uob-hep-cad/uob-hep-pc074/README.md

# Simple Charge Sensitive Amplifier with Integrated Shaping Amplifier

1000 electrons --> 8mV at output of shaper . i.e. ~ 50V/pC
