uob-hep-cad/uob-hep-pc074/www/Schematics/UoB TICSP.pdf

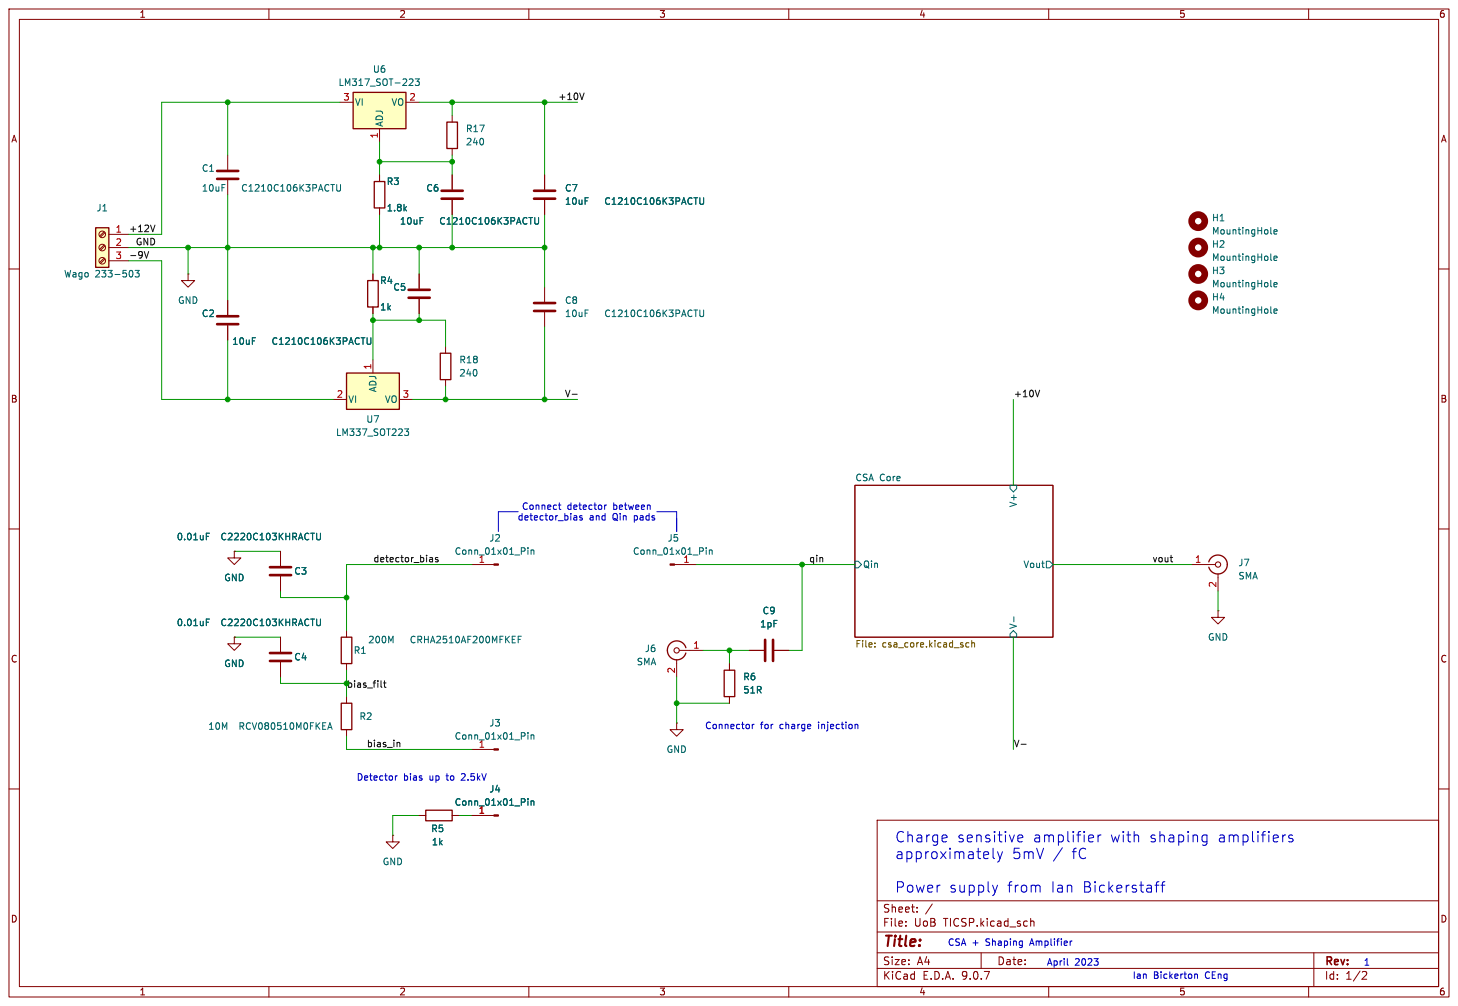
[picture p1: page 1]

Power supply from Ian Bickerstaff

April 2023 CSA + Shaping Amplifier

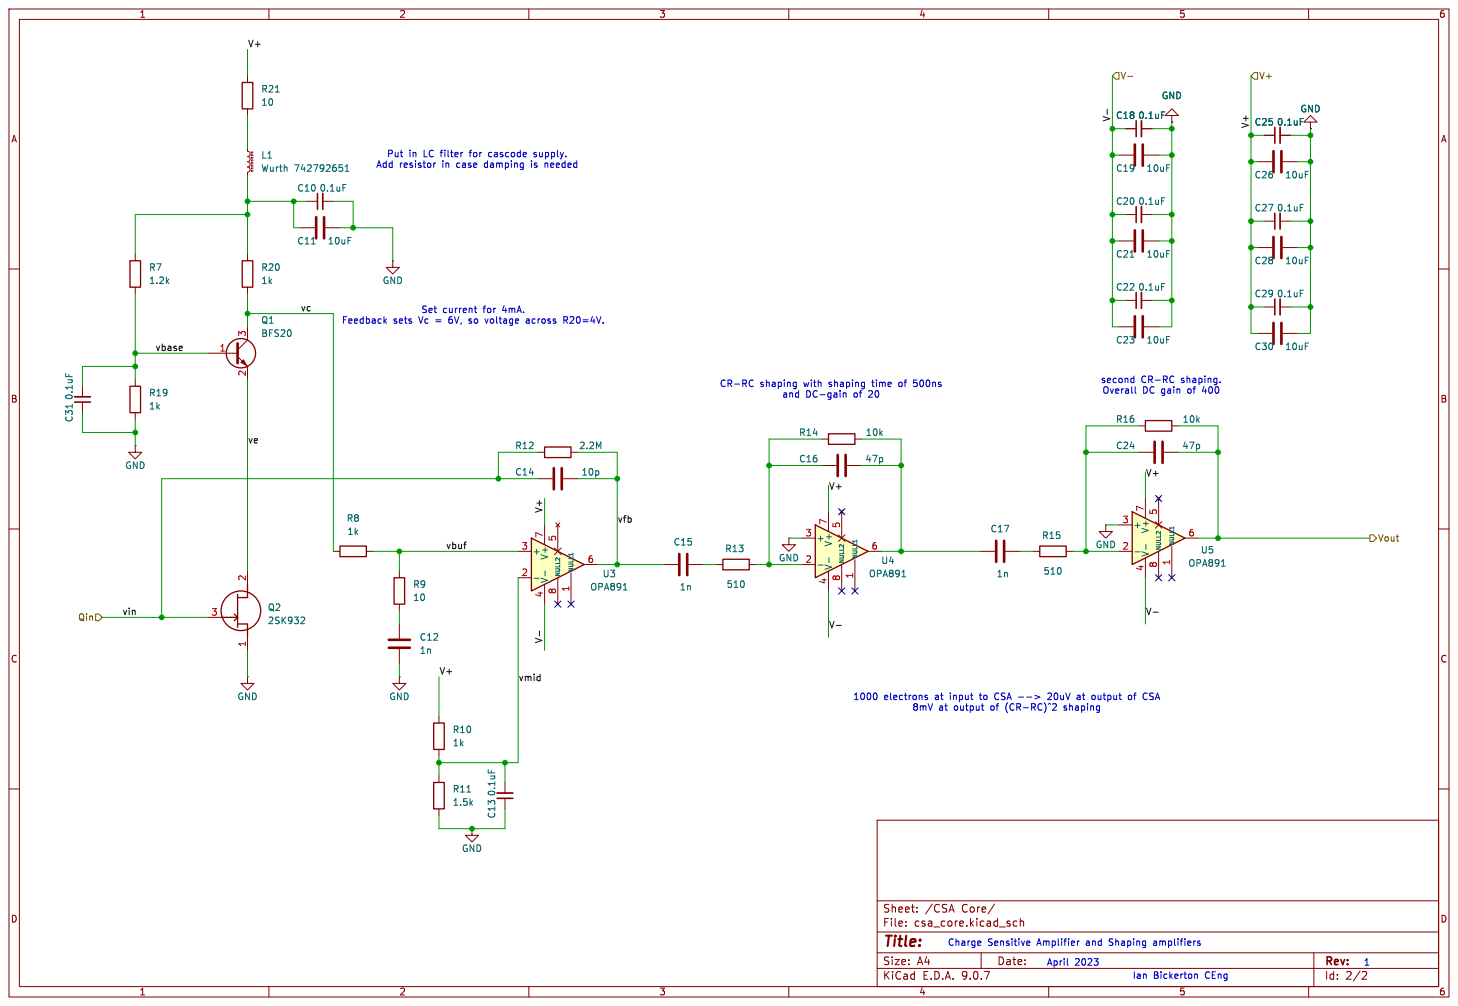
[picture p2: page 2]

Id: 2/2 Title: File: csa_core.kicad_sch Sheet: /CSA Core/
