uob-hep-cad/uob-hep-pc074/hardware/KiCad/uob-hep-pc074/uob-hep-pc074.kicad_pcb

## KiCad design hardware/KiCad/uob-hep-pc074/uob-hep-pc074.kicad_pcb (2026-04-07)

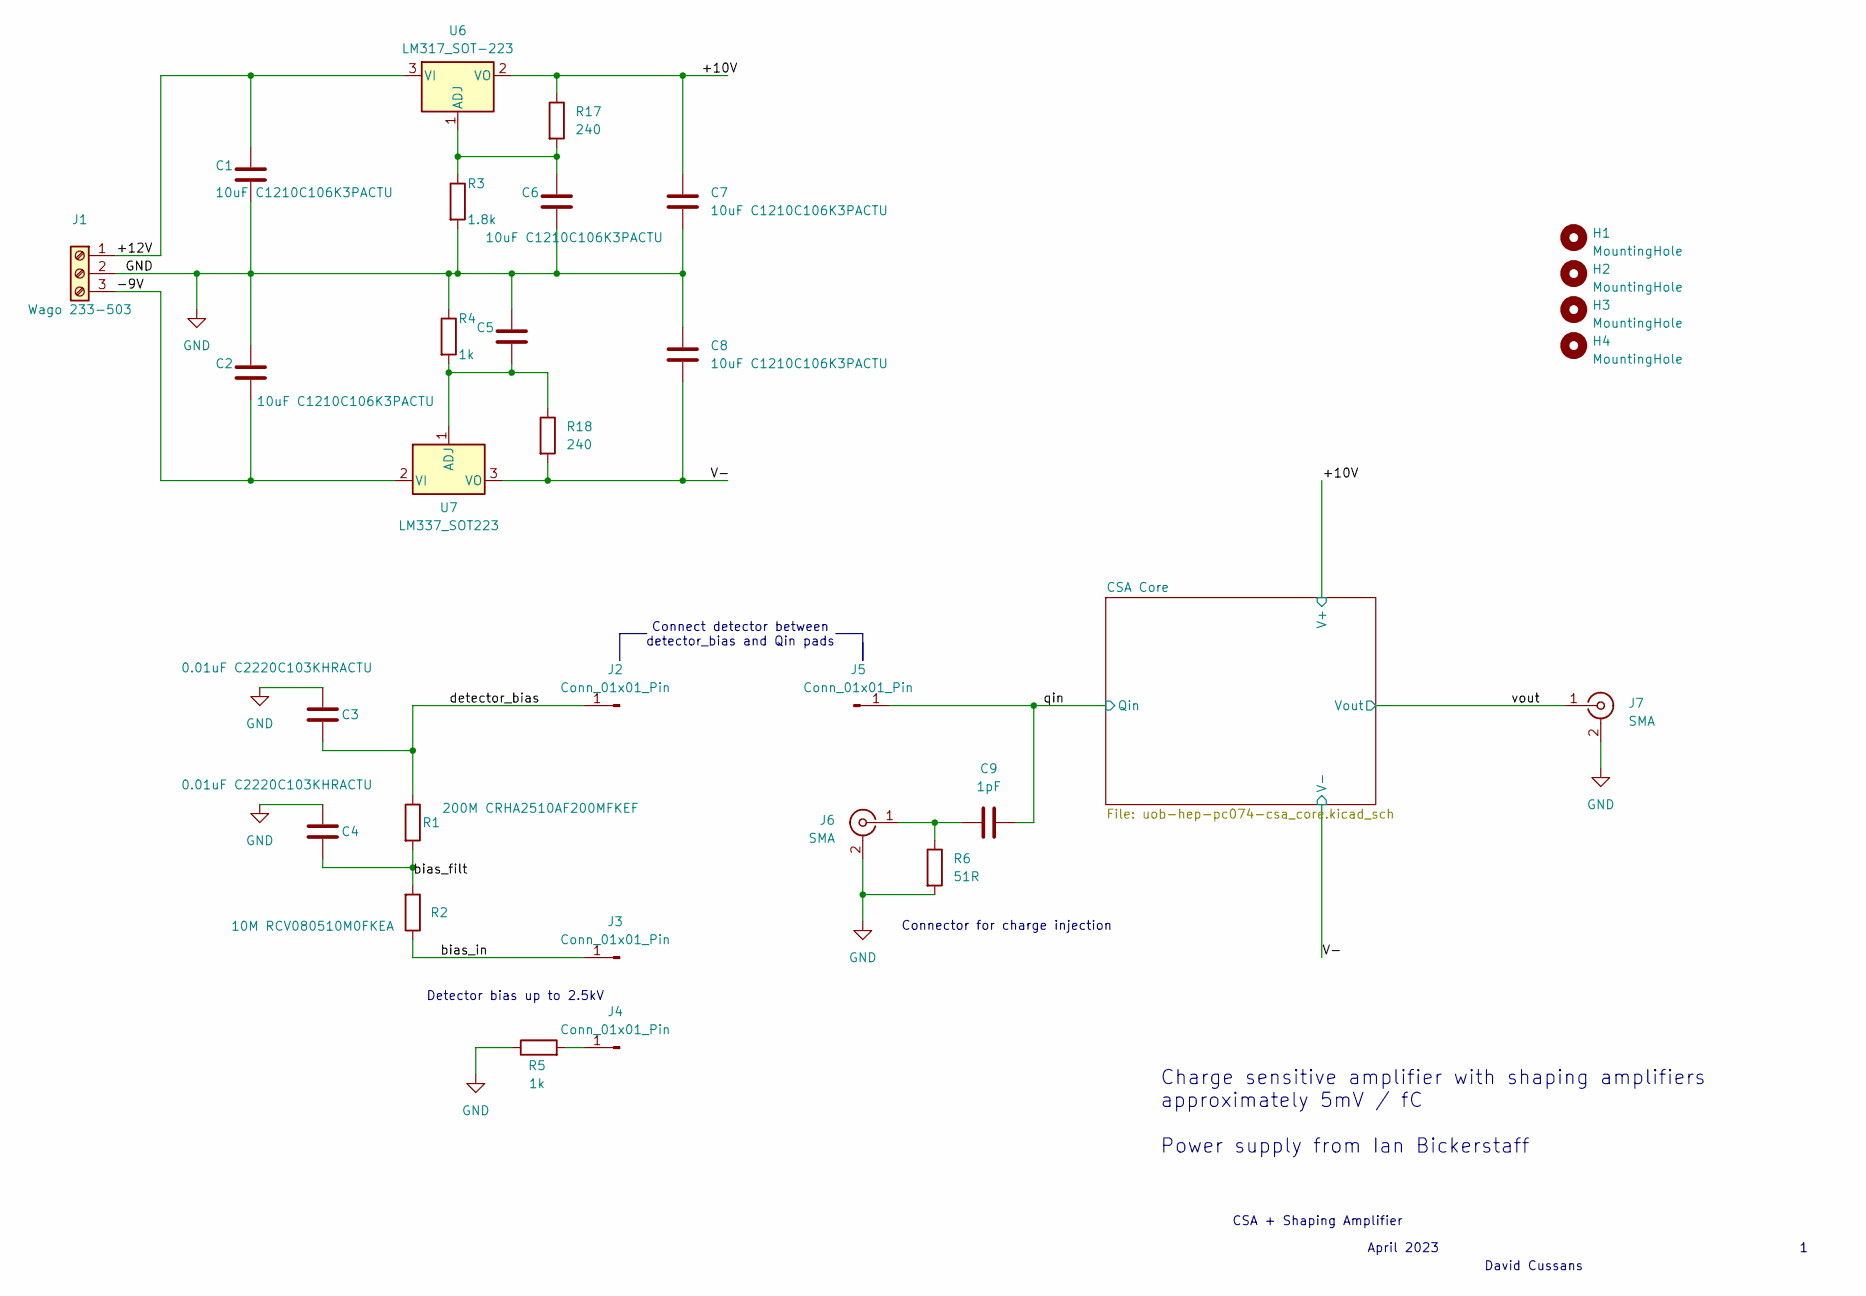
[picture p3: schematic uob-hep-pc074.kicad_sch]

Parts:
C1, C2, C5, C6, C7, C8: 10uF C1210C106K3PACTU; C_1210_3225Metric
C3, C4: 0.01uF C2220C103KHRACTU; C_2220_5750Metric_Pad1.97x5.40mm_HandSolder
C9: 1pF; C_0603_1608Metric_Pad1.08x0.95mm_HandSolder
H1, H2, H3, H4: MountingHole; MountingHole_2.7mm_M2.5
J1: Wago 233-503; TerminalBlock_WAGO_233-503_1x03_P2.54mm_45Degree
J2, J3, J4, J5: Conn_01x01_Pin; SolderWire-2sqmm_1x01_D2mm_OD3.9mm
J6, J7: SMA; SMA_Amphenol_901-144_Vertical
R1: 200M CRHA2510AF200MFKEF; R_2512_6332Metric_Pad1.40x3.35mm_HandSolder
R2: 10M RCV080510M0FKEA; R_0805_2012Metric
R3: 1.8k; R_0603_1608Metric_Pad0.98x0.95mm_HandSolder
R4, R5: 1k; R_0603_1608Metric_Pad0.98x0.95mm_HandSolder
R6: 51R; R_0603_1608Metric_Pad0.98x0.95mm_HandSolder
R17, R18: 240; R_0603_1608Metric_Pad0.98x0.95mm_HandSolder
U6: LM317_SOT-223; SOT-223-3_TabPin2
U7: LM337_SOT223; SOT-223-3_TabPin2

Connections:
/+10V: C7.1, R17.1, U6.2 (VO); also elsewhere on the board
/+12V: C1.1, J1.1, U6.3 (VI)
/-9V: C2.2, J1.3, U7.2 (VI)
/V-: C8.2, R18.2, U7.3 (VO); also elsewhere on the board
/bias_filt: C4.1, R1.2, R2.2
/bias_in: J3.1, R2.1
/detector_bias: C3.1, J2.1, R1.1
/qin: C9.2, J5.1; also elsewhere on the board
/vout: J7.1 (In); also elsewhere on the board
GND: C1.2, C2.1, C3.2, C4.2, C5.1, C6.2, C7.2, C8.1, J1.2, J6.2 (Ext), J7.2 (Ext), R3.2, R4.1, R5.1, R6.2; also elsewhere on the board
unnamed: J4.1, R5.2
unnamed: C9.1, J6.1 (In), R6.1
unnamed: C6.1, R3.1, R17.2, U6.1 (ADJ)
unnamed: C5.2, R4.2, R18.1, U7.1 (ADJ)

Notes on the sheet:
CSA + Shaping Amplifier
David Cussans
Connector for charge injection
Detector bias up to 2.5kV
Charge sensitive amplifier with shaping amplifiers approximately 5mV / fC Power supply from Ian Bickerstaff
Connect detector between detector_bias and Qin pads
April 2023

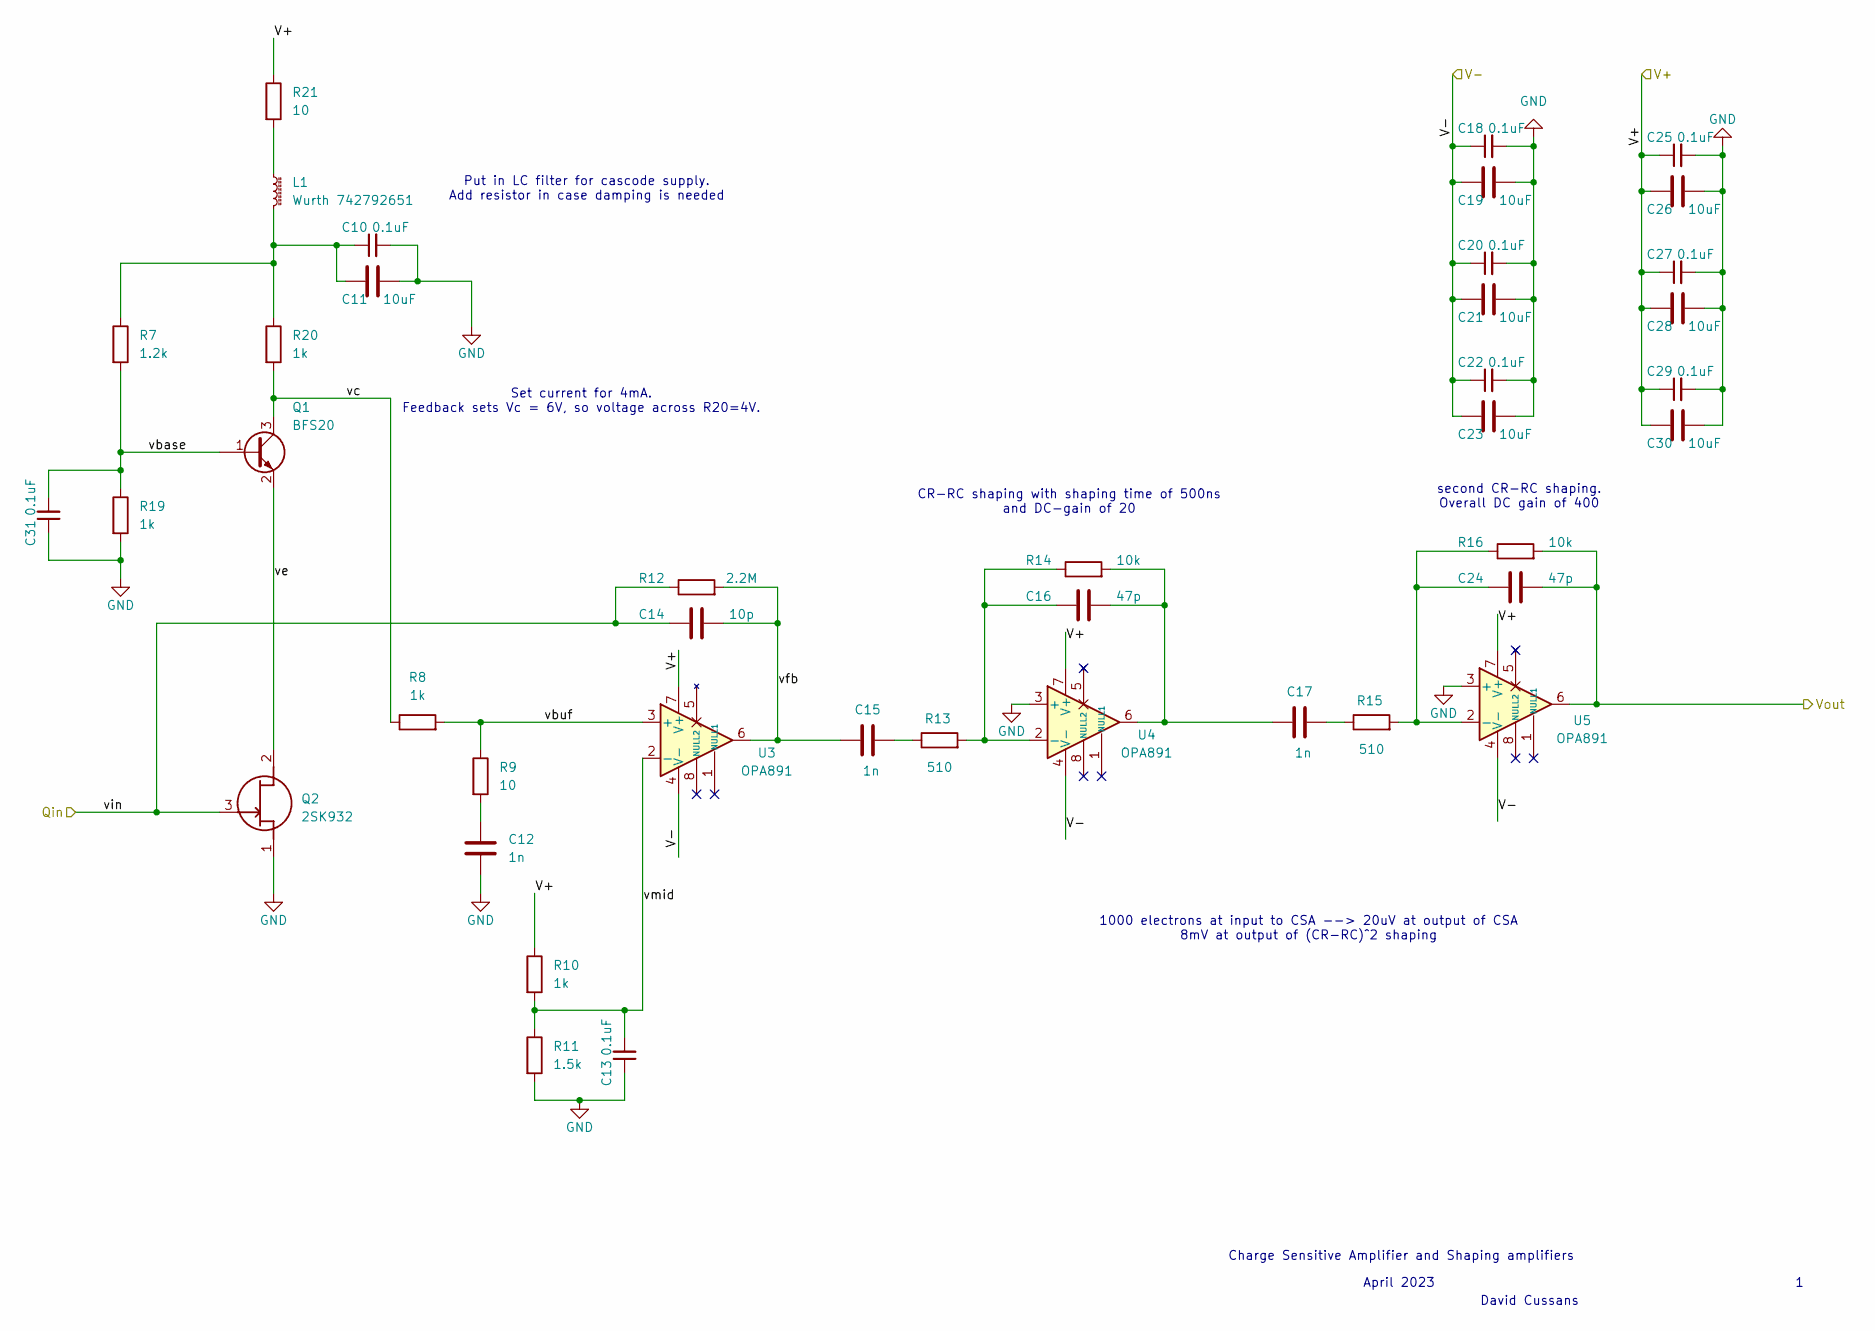
[picture p4: schematic uob-hep-pc074-csa_core.kicad_sch]

Parts:
C10, C13, C18, C20, C22, C25, C27, C29, C31: 0.1uF; C_0805_2012Metric
C11, C19, C21, C23, C26, C28, C30: 10uF; C_0805_2012Metric
C12: 1n; C_0603_1608Metric_Pad1.08x0.95mm_HandSolder
C14: 10p; R_0603_1608Metric_Pad0.98x0.95mm_HandSolder
C15, C17: 1n; R_0603_1608Metric_Pad0.98x0.95mm_HandSolder
C16, C24: 47p; R_0603_1608Metric_Pad0.98x0.95mm_HandSolder
L1: Wurth 742792651; L_0603_1608Metric_Pad1.05x0.95mm_HandSolder
Q1: BFS20; SOT-23
Q2: 2SK932; SOT-23; Manufacturer_Part_Number 2SK932
R7: 1.2k; R_0603_1608Metric_Pad0.98x0.95mm_HandSolder
R8, R10, R19, R20: 1k; R_0603_1608Metric_Pad0.98x0.95mm_HandSolder
R9, R21: 10; R_0603_1608Metric_Pad0.98x0.95mm_HandSolder
R11: 1.5k; R_0603_1608Metric_Pad0.98x0.95mm_HandSolder
R12: 2.2M; R_0603_1608Metric_Pad0.98x0.95mm_HandSolder
R13, R15: 510; R_0603_1608Metric_Pad0.98x0.95mm_HandSolder
R14, R16: 10k; R_0603_1608Metric_Pad0.98x0.95mm_HandSolder
U3, U4, U5: OPA891; SOIC-8_5.275x5.275mm_P1.27mm

Connections:
/+10V: C25.1, C26.1, C27.1, C28.1, C29.1, C30.1, R10.1, R21.1, U3.7 (V+), U4.7 (V+), U5.7 (V+); also elsewhere on the board
/CSA Core/vbase: C31.2, Q1.1 (B), R7.2, R19.1
/CSA Core/vbuf: R8.2, R9.1, U3.3 (+)
/CSA Core/vc: Q1.3 (C), R8.1, R20.2
/CSA Core/ve: Q1.2 (E), Q2.2 (D)
/CSA Core/vfb: C14.2, C15.1, R12.2, U3.6
/CSA Core/vmid: C13.2, R10.2, R11.1, U3.2 (-)
/V-: C18.1, C19.1, C20.1, C21.1, C22.1, C23.1, U3.4 (V-), U4.4 (V-), U5.4 (V-); also elsewhere on the board
/qin: C14.1, Q2.3 (G), R12.1; also elsewhere on the board
/vout: C24.2, R16.2, U5.6; also elsewhere on the board
GND: C10.2, C11.2, C12.2, C13.1, C18.2, C19.2, C20.2, C21.2, C22.2, C23.2, C25.2, C26.2, C27.2, C28.2, C29.2, C30.2, C31.1, Q2.1 (S), R11.2, R19.2, U4.3 (+), U5.3 (+); also elsewhere on the board
unnamed: C10.1, C11.1, L1.2, R7.1, R20.1
unnamed: C12.1, R9.2
unnamed: C15.2, R13.1
unnamed: C16.2, C17.1, R14.2, U4.6
unnamed: C17.2, R15.1
unnamed: L1.1, R21.2
unnamed: C16.1, R13.2, R14.1, U4.2 (-)
unnamed: C24.1, R15.2, R16.1, U5.2 (-)

Notes on the sheet:
CR-RC shaping with shaping time of 500ns and DC-gain of 20
Charge Sensitive Amplifier and Shaping amplifiers
David Cussans
second CR-RC shaping. Overall DC gain of 400
1000 electrons at input to CSA --> 20uV at output of CSA 8mV at output of (CR-RC)^2 shaping
Set current for 4mA. Feedback sets Vc = 6V, so voltage across R20=4V.
Put in LC filter for cascode supply. Add resistor in case damping is needed
April 2023

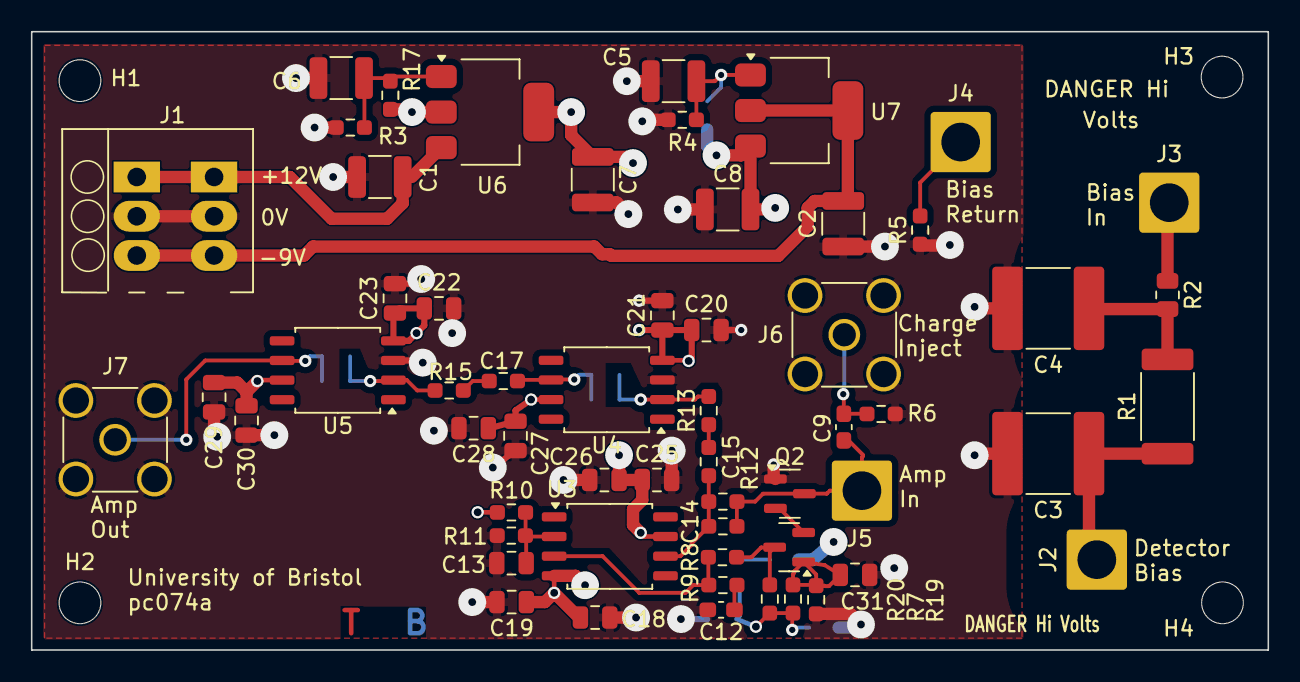
[picture p5: board uob-hep-pc074.kicad_pcb from above]

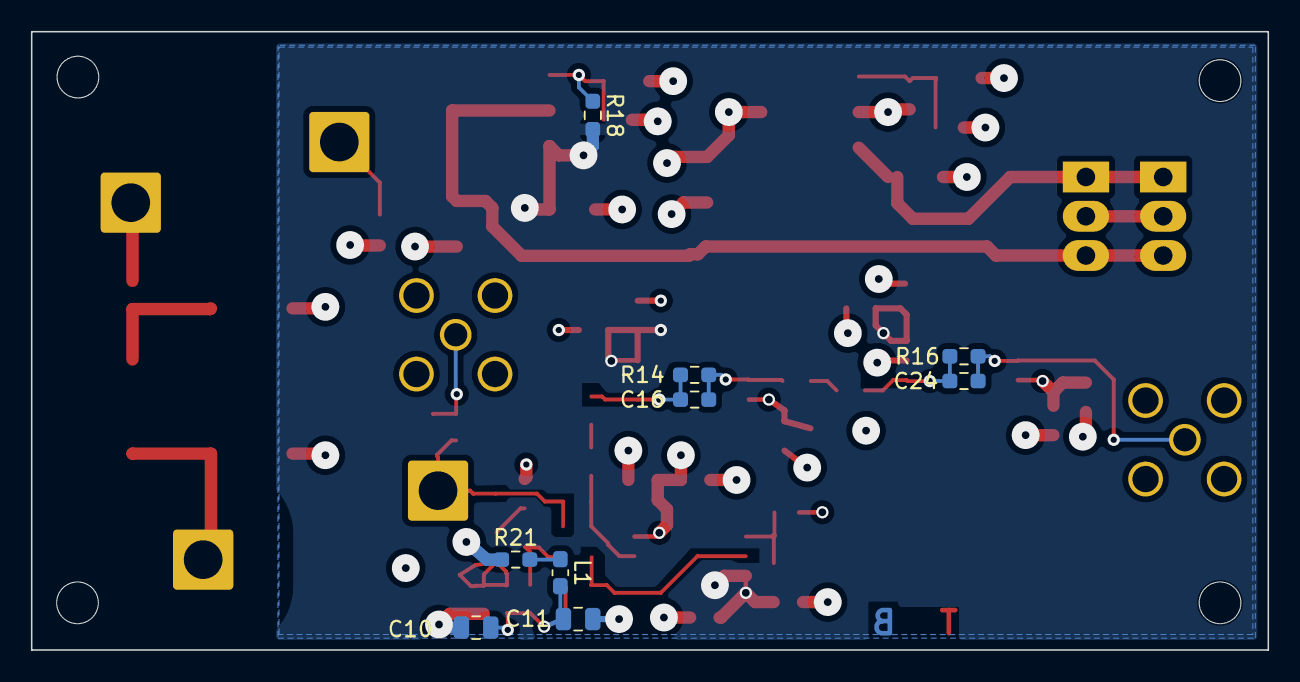
[picture p6: board uob-hep-pc074.kicad_pcb from below]

Board: 4 copper layers, 80.0 x 40.0 mm, 71 parts (9 on the bottom side), 28 nets.
