uob-hep-cad/uob-hep-pc074/(commit log)

2024-04-11 More schemataic tidying. Added a csa_core_simulation.kicad_pro to simulate CSA core. Tidied csa_core to make it simulatable, but needs work - OP analysis doesn't converge at the moment. (Need to fidd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
    [UoB TICSP.kicad_sch, csa_core.kicad_sch, csa_core_simulation.kicad_pcb, csa_core_simulation.kicad_sch, shaper_amplifier.kicad_sch]
2024-04-29 Added lead-lag compenstation after JFET which seems to stabilize loop in simulation. Added CR-RC shaping/amplification. Committing changes before starting simulation of shapers
    [csa_core.kicad_sch, csa_core_phase_margin_simulation.kicad_pcb, csa_core_phase_margin_simulation.kicad_sch, csa_core_sim-opamp.kicad_sch, csa_core_simulation_opamp_29apr24_01.csv, csa_core_simulation_sim-opamp.kicad_pcb, csa_core_simulation_sim-opamp.kicad_sch]
2024-04-29 End of day save. Just needs voids added to planes to reduce capacitance
    [UoB TICSP.kicad_pcb, UoB TICSP.kicad_sch, csa_core.kicad_sch, csa_core_sim-opamp.kicad_sch, csa_core_simulation_sim-opamp.kicad_sch]
2026-03-18 Generated artwork
    [UoB TICSP-B_Cu.gbr, UoB TICSP-B_Mask.gbr, UoB TICSP-B_Paste.gbr, UoB TICSP-B_Silkscreen.gbr, UoB TICSP-Edge_Cuts.gbr, UoB TICSP-F_Cu.gbr, UoB TICSP-F_Mask.gbr, UoB TICSP-F_Paste.gbr]
2026-03-18 Produced gerbers
    [UoB TICSP-B_Cu.gbr, UoB TICSP-B_Mask.gbr, UoB TICSP-B_Paste.gbr, UoB TICSP-B_Silkscreen.gbr, UoB TICSP-Edge_Cuts.gbr, UoB TICSP-F_Cu.gbr, UoB TICSP-F_Mask.gbr, UoB TICSP-F_Paste.gbr]
2026-03-18 Printed PDF schemaics. Saved schematic and PCB as KiCAD 9
    [UoB TICSP.kicad_pcb, UoB TICSP.kicad_sch, csa_core.kicad_sch]
2026-04-07 Copied UoB TICSP project to hardware/KiCAD/uob-hep-pc074
    [csa_core.kicad_sch, csa_core_phase_margin_simulation.kicad_pcb, csa_core_phase_margin_simulation.kicad_sch, csa_core_sim-opamp.kicad_sch, csa_core_simulation.kicad_pcb, csa_core_simulation.kicad_sch, csa_core_simulation_opamp_29apr24_01.csv, csa_core_simulation_sim-opamp.kicad_pcb]
